konosubakonoakua/hw-ftdi-jtag-xilinx/README.md

# hw-ftdi-jtag-xilinx

## Version 1 [❌]
- has bug with the auto-direction level shifter, only works with slow rate
- has manufacturing limit with the jtag & usb track due to JLCPCB limitaion
- has wrong silk print for rx/tx
- LEDs for UART not working
- BUG: cannot download flash if JTAG f_tck > 1MHz (~5MHz~) (roughly), I really don't know Y, cause the BIT file can be downloaded at 30MHz rate.

### 3d model

<details>

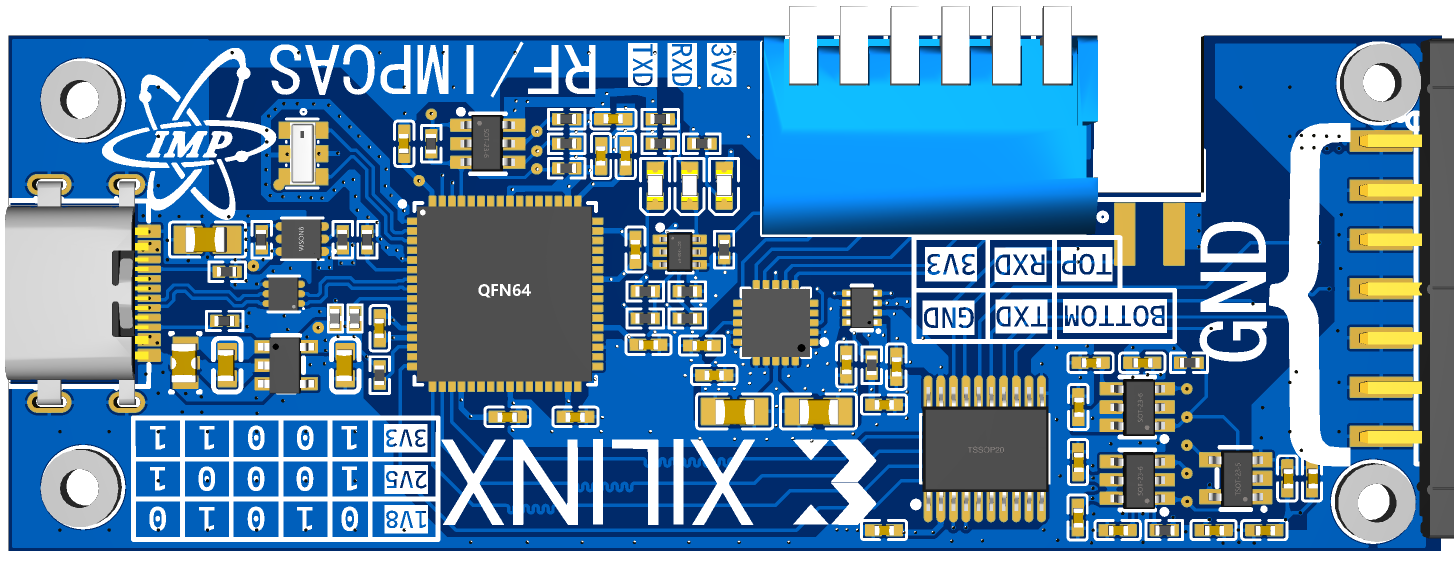
[picture p1: images/top_3d.png]
top_3d_v1
  
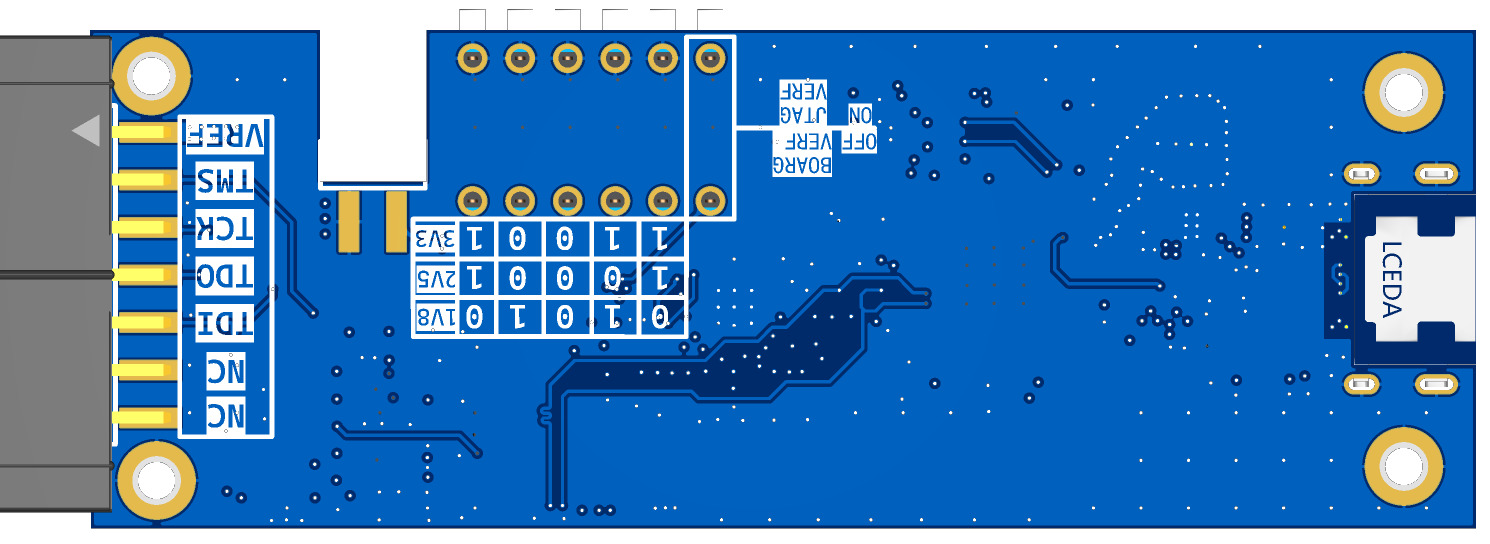
[picture p2: images/bottom_3d.png]
bottom_3d_v1
  

</details>

### pcb photo

<details>

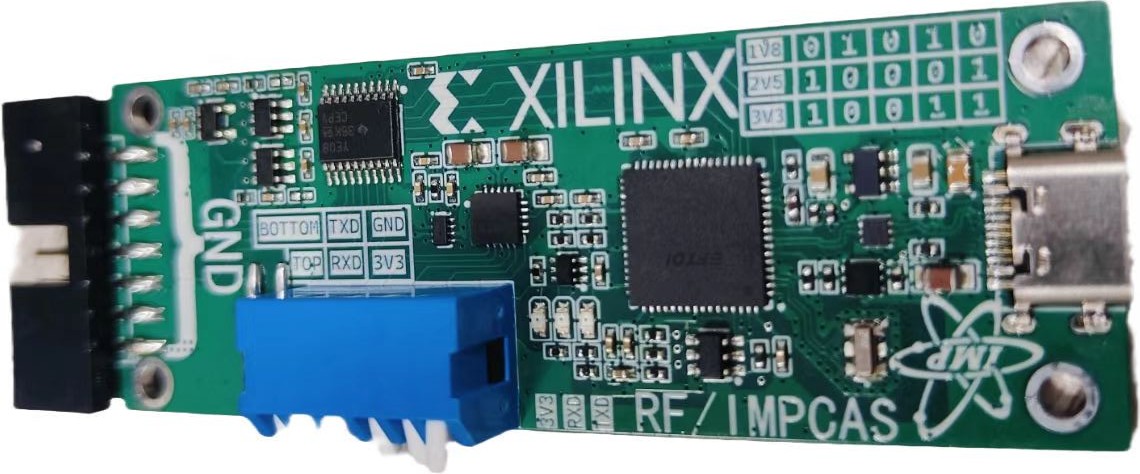
[picture p3: images/v1.jpg]
pcb v1
  

</details>

## Version 2 [❌]
- LEDs for UART not working
- replace auto-direction level shifters with fix-direction ones
- satisfy the JLC track to track clearance limit

### 3d model

<details>

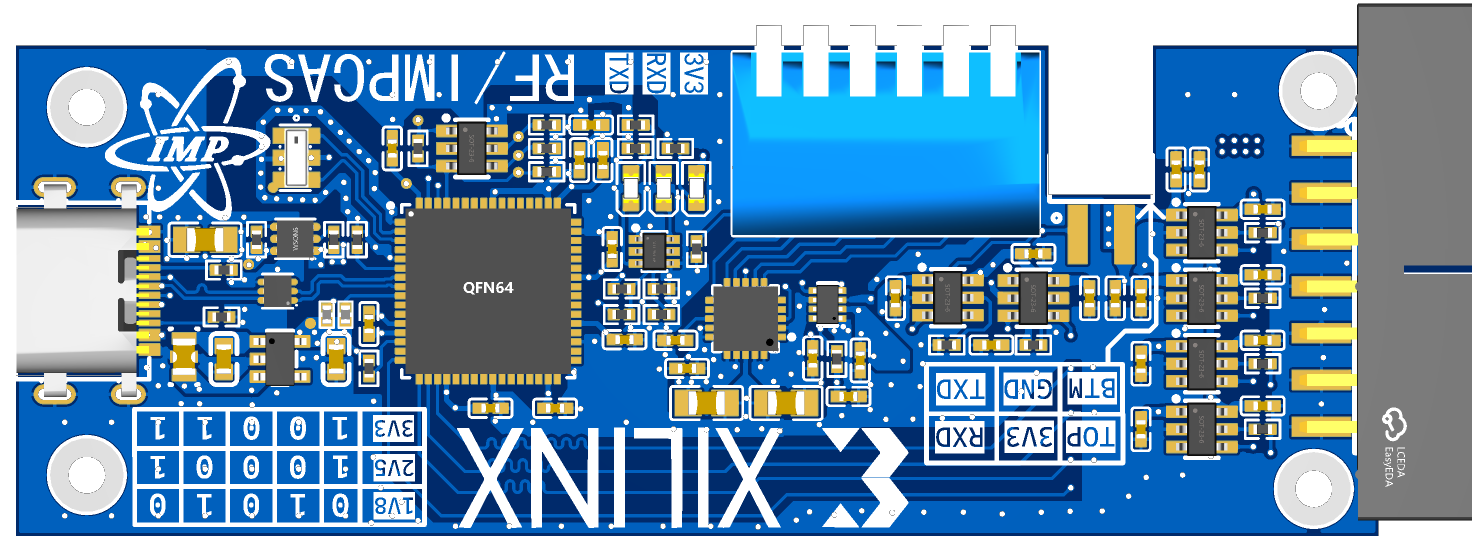
[picture p4: images/v2_top_3d.png]
  

</details>

### pcb photo

<details>

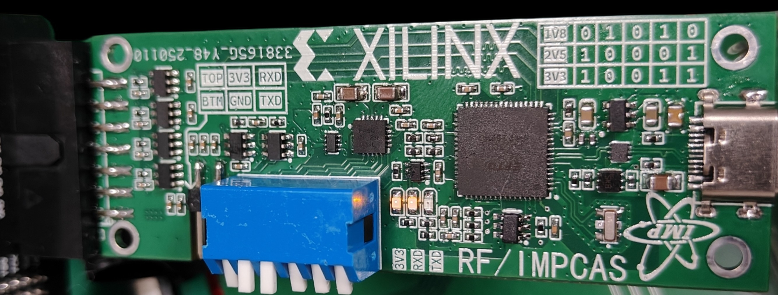
[picture p5: images/v2.jpg]
pcb v2
  

</details>

## Version 2.1 [✅]
- use RX/TX LED pin on ftdi chip
- add TVS diodes
- replace murata 3pin 0.5% crystal with 4pin 10ppm crystal
- new top silk logos
- able to adapt several votage levels with internal voltage reference [removed in v3]

### 3d model

<details>

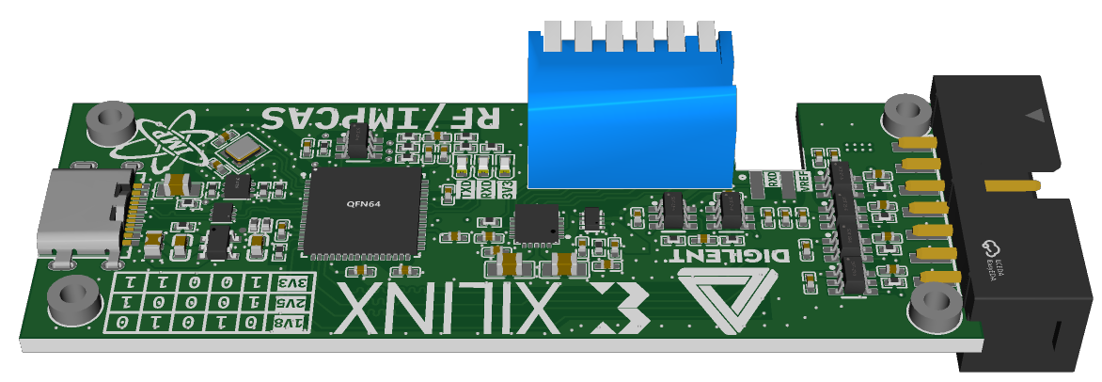
[picture p6: images/v2.1_3d.png]
  

</details>

### pcb photo [WIP]

<details>

  pcb v2

</details>

## Version 3 [❌]
- remove on board voltage select
- add TVS diodes
- use 10-pin jtag header instead
- use RX/TX LED pin on ftdi chip

### 3d model

<details>

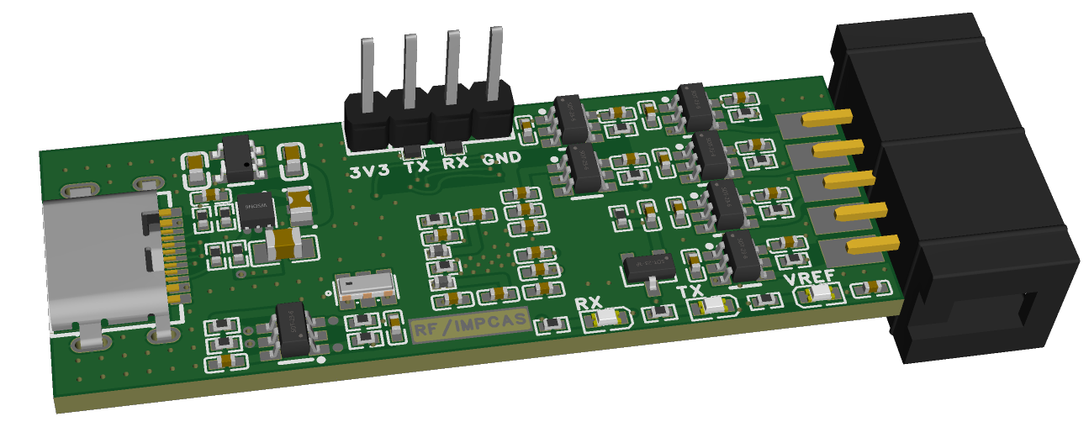
[picture p7: images/v3_3d.png]
top_3d_v3
  

</details>

### pcb photo

<details>

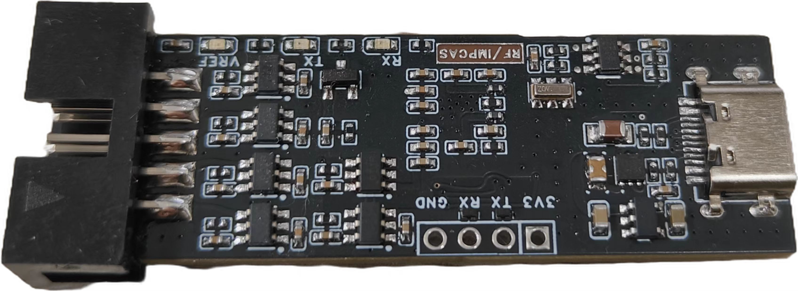
[picture p8: images/v3.jpg]
pcb v3
  

</details>

## Version 3.1 [✅]
- replace murata 3pin 0.5% crystal with 4pin 10ppm crystal

### 3d model

<details>

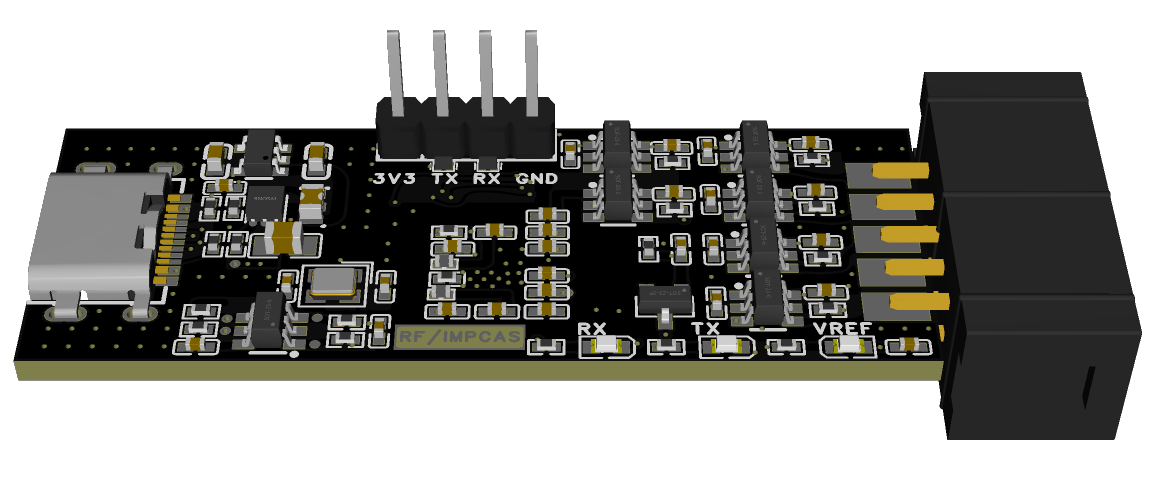
[picture p9: images/v3.1_3d.png]
top_3d_v3.1
  

</details>

### pcb photo [WIP]

<details>

  pcb v3.1

</details>

## Version 3.2 [✅]
- use VREF instead of 3V3 for UART 4pin header

### 3d model

<details>

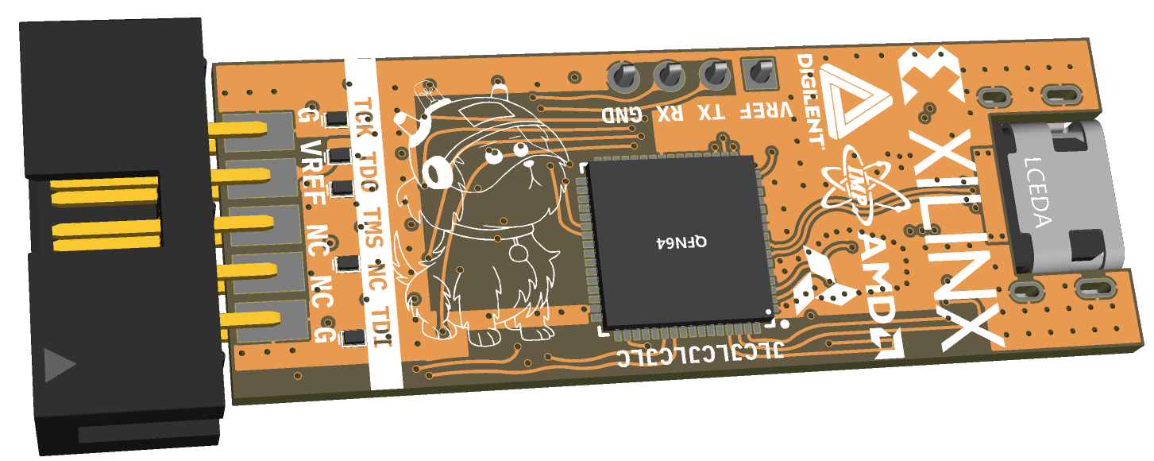
[picture p10: images/v3.2_3d.png]
top_3d_v3.2
  

</details>

### pcb photo [WIP]

<details>

  pcb v3.2

</details>

## Notes
- the murata 12MHz crystal cannot satisfy 30ppm, instead, its precision has only 0.5%.
  - This is the ***root cause*** of all stupid bugs I have encounter so far, FU**!!!
  - I choose to solder a DT-38 crystal instead as a workaround.
  - Version 1/2/3 are all fucked.
  - This murata crystal will be replaced in future version.
  - I tested 0.07% murata 12MHz crystal, it worked, but not sure about its long-term stablization.

## Production
- For linux
  ```bash
  # remove ftdi kernel driver everytime if you plug ftdi in
  sudo rmmod ftdi_sio && sudo rmmod usbserial
  ```
  ```bash
  # otherwise, program_ftdi will be not found
  source /tools/Xilinx/Vivado/2024.2/settings64.sh && vivado
  ```
- Inside vivado
  ```tcl
  # tested withvivado 2024.2
  program_ftdi -write -f FT2232H -s 0000003 -v "RF/IMPCAS" -b "custom" -d "FT2232H JTAG Cable 10P"
  ```
