konosubakonoakua/hw-ftdi-jtag-xilinx/(list of files, drawings)

Other design files:
projects/ProPrj_ftdi-jtag-xilinx-14pin_2025-03-20_v2.1.epro
projects/ProPrj_ftdi-jtag-xilinx_2025-01-01.epro
projects/ProPrj_ftdi-jtag-xilinx_2025-01-10_v2.epro
projects/ProPrj_ftdi-jtag-xilinx_2025-03-12_v3.epro
projects/ProPrj_ftdi-jtag-xilinx_2025-03-20_v3.1.epro
projects/ProPrj_ftdi-jtag-xilinx_2025-03-20_v3.2.epro
