konosubakonoakua/hw-ftdi-jtag-xilinx/(commit log)

2025-01-10 update to v2
    [ProPrj_ftdi-jtag-xilinx_2025-01-10_v2.epro]
2025-03-17 feat: add version3
    [ProPrj_ftdi-jtag-xilinx_2025-03-12_v3.epro]
2025-03-20 feat: update v3.1
    [ProPrj_ftdi-jtag-xilinx_2025-03-20_v3.1.epro]
2025-03-20 feat: update v3.2
    [ProPrj_ftdi-jtag-xilinx_2025-03-20_v3.2.epro]
2025-03-20 feat: update v2.1
    [ProPrj_ftdi-jtag-xilinx-14pin_2025-03-20_v2.1.epro]
